jaisor/SNAP_Power_Mini/docs/images/pcb-iso.png

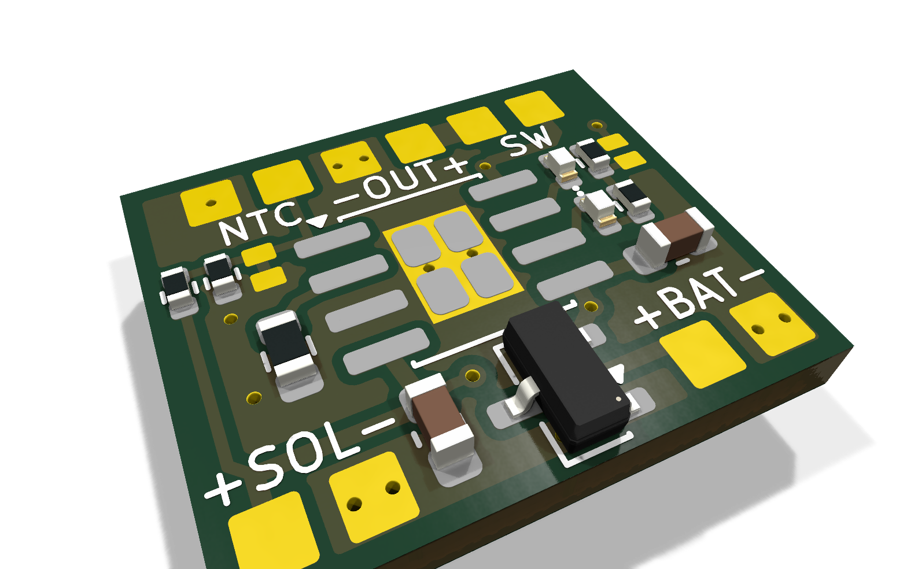
docs/images/pcb-iso.png
