jaisor/SNAP_Power_Mini/SNAP_Power_Mini.kicad_pcb

## KiCad design SNAP_Power_Mini.kicad_pcb (2026-11-14)

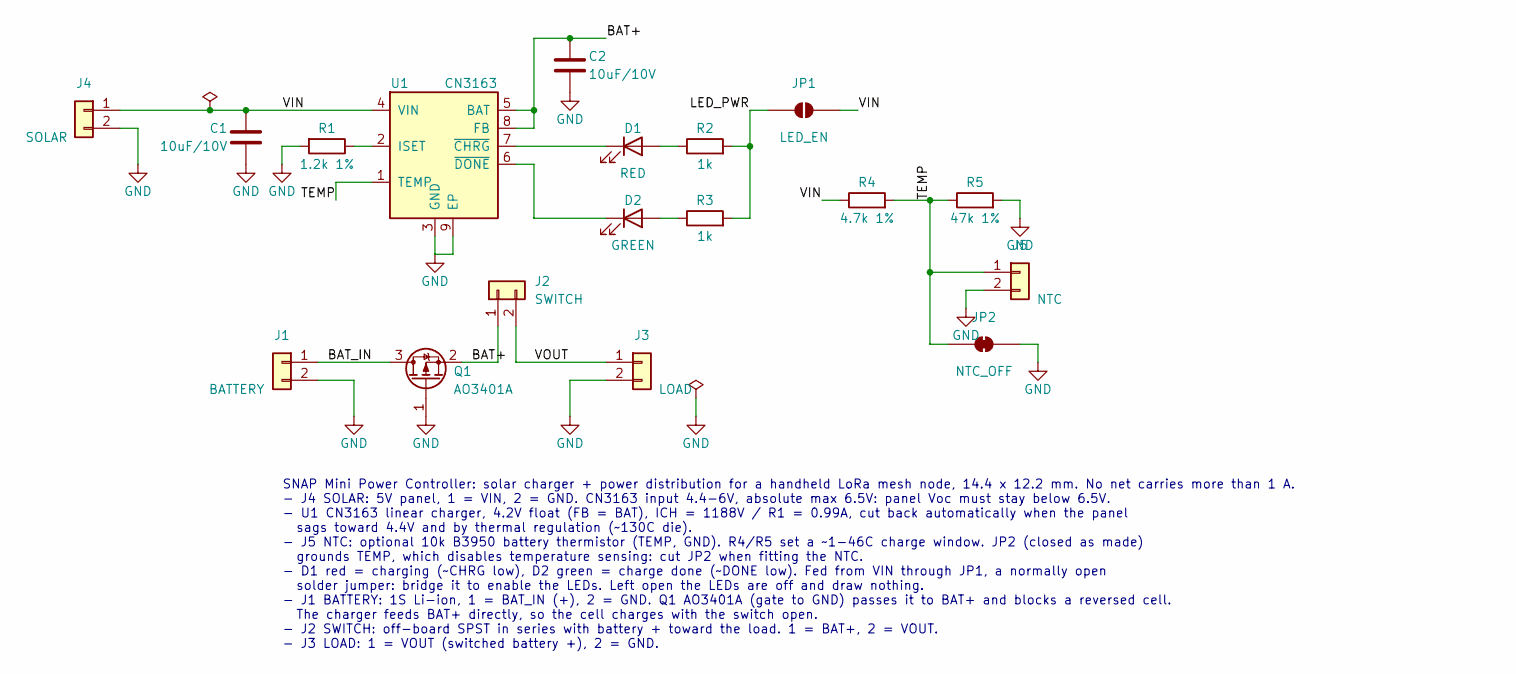
[picture p4: schematic SNAP_Power_Mini.kicad_sch, SNAP Mini Power Controller]

Parts:
C1, C2: 10uF/10V; C_0603_1608Metric
D1: RED; LED_0402_1005Metric
D2: GREEN; LED_0402_1005Metric
J1: BATTERY; WirePad_1x02_SMD_1.4x1.5mm_P2.0mm
J2: SWITCH; WirePad_1x02_SMD_1.4x1.5mm_P2.0mm
J3: LOAD; WirePad_1x02_SMD_1.4x1.5mm_P2.0mm
J4: SOLAR; WirePad_1x02_SMD_1.4x1.5mm_P2.0mm
J5: NTC; WirePad_1x02_SMD_1.4x1.5mm_P2.0mm
JP1: LED_EN; SolderJumper-2_P0.9mm_Open_Pad0.6x0.8mm
JP2: NTC_OFF; SolderJumper-2_P0.9mm_Bridged_Pad0.6x0.8mm
Q1: AO3401A; SOT-23
R1: 1.2k 1%; R_0603_1608Metric
R2, R3: 1k; R_0402_1005Metric
R4: 4.7k 1%; R_0402_1005Metric
R5: 47k 1%; R_0402_1005Metric
U1: CN3163; SOIC-8-1EP_3.9x4.9mm_P1.27mm_EP2.41x3.3mm

Connections:
/BAT+: C2.1, J2.1, Q1.2 (S), U1.5 (BAT), U1.8 (FB)
/BAT_IN: J1.1, Q1.3 (D)
/LED_PWR: JP1.1 (A), R2.2, R3.2
/TEMP: J5.1, JP2.1 (A), R4.2, R5.1, U1.1 (TEMP)
/VIN: C1.1, J4.1, JP1.2 (B), R4.1, U1.4 (VIN)
/VOUT: J2.2, J3.1
GND: C1.2, C2.2, J1.2, J3.2, J4.2, J5.2, JP2.2 (B), Q1.1 (G), R1.2, R5.2, U1.3 (GND), U1.9 (EP)
unnamed: D1.2 (A), R2.1
unnamed: D1.1 (K), U1.7 (~CHRG)
unnamed: D2.2 (A), R3.1
unnamed: D2.1 (K), U1.6 (~DONE)
unnamed: R1.1, U1.2 (ISET)

Notes on the sheet:
SNAP Mini Power Controller: solar charger + power distribution for a handheld LoRa mesh node, 14.4 x 12.2 mm. No net carries more than 1 A. - J4 SOLAR: 5V panel, 1 = VIN, 2 = GND. CN3163 input 4.4-6V, absolute max 6.5V: panel Voc must stay below 6.5V. - U1 CN3163 linear charger, 4.2V float (FB = BA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

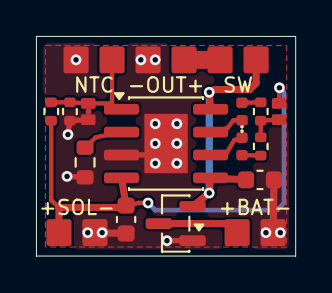
[picture p5: board SNAP_Power_Mini.kicad_pcb from above]

Board: 2 copper layers, 14.4 x 12.2 mm, 18 parts (0 on the bottom side), 12 nets.
