jaisor/SNAP_Power_Mini/(commit log)

2026-10-30 feat: add 20x10 mm wire-pad power distribution board
    Minimal PDB with solder pads for a battery, an off-board switch in series
    with battery +, and a load, plus two M2 mounting holes. The switch is wired
    off-board because slide switches small enough for this footprint are
    rated around 0.5 A.
    Pads are 2.9 x 3.6 mm in three columns (BAT, SW, OUT), + row on top. F.Cu
    carries the BAT+ bridge; on B.Cu a VOUT zone and a GND zone cross under the
    switch pads, reached by via-in-pad. Rated about 5 A on 1 oz copper,
    limited by the three VOUT vias and the 2.3 mm GND strip.
    Corners are square so panels can be V-scored edge to edge; rounded corners
    would need tab routing with gaps between boards.
    The sc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
    [MiniPDB.kicad_pcb, MiniPDB.kicad_sch]
2026-10-30 feat: add CN3163 solar charger with status LEDs and solar pads
    Add a CN3163 linear charger, modelled on the SD05CRMA module and the
    datasheet's Figure 1: R_ISET 1.2k for 0.99 A, FB tied to BAT for a
    4.2 V float, TEMP grounded (bare cell, no NTC), 10 uF on VIN and BAT.
    Red and green 0402 LEDs with 1k resistors hang from VIN on ~CHRG and
    ~DONE, so they light only while the panel supplies power.
    The charger feeds BAT+ on the cell side of the switch, so the cell
    charges with the switch open and the panel never powers the load
    while it is switched off.
    No net carries more than 1 A, so the wire pads shrink to 2.0 x 2.1 mm
    and the v1 copper planes become 0.4 mm tracks. A SOL pad pair joins
    the pa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
    [MiniPDB.kicad_pcb, MiniPDB.kicad_sch]
2026-10-30 refactor: rename project to SolarMeshMiniPDB
    The board is the power stage of a mini handheld solar LoRa mesh node,
    so the name now says that. Rename the KiCad project files, the project
    symbol and footprint libraries (and the lib IDs that point at them),
    title blocks, docs and the Gerber zip name.
    Schematic UUIDs stay seeded with the old name (UUID_SEED) so symbol
    identities and the footprint links do not churn.
    The back silkscreen now reads "SolarMeshMiniPDB" / "v2.0 by
    JaisorGadgets". The second line sits below the M2 holes, so it may use
    the board width instead of the gap between the holes; that keeps it at
    the 0.8 mm minimum text height instead of shrinking it to 0.76 mm.
    ERC: 0 items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
    [SolarMeshMiniPDB.kicad_pcb, SolarMeshMiniPDB.kicad_sch]
2026-10-31 feat(fab): generate JLCPCB BOM and CPL with LCSC part numbers
    Add tools/fab-package.js, adapted from SolarNodeChargeController. It turns
    KiCad's BOM and position CSVs into JLCPCB-format BOM/CPL files, writes
    FAB_NOTES.txt and zips the Gerbers, replacing the python zip one-liner.
    Every BOM line has an LCSC number, each checked on its jlcpcb.com part page:
    CN3163 C559031, 1.2k 0603 C22765, 1k 0402 C11702, 10uF 0603 C19702, and the
    NationStar 0402 LEDs C130719 (red) / C130723 (green). The CN3163 and LEDs are
    Extended parts.
    The CPL keeps KiCad's rotations with no per-package corrections, so the docs
    say to check U1 and the LED polarity in the assembler's preview. CPL
    coordinates match the Ger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
2026-11-12 refactor: rename project to SNAP Mini Power Controller
    Files, KiCad libraries and lib IDs become SNAP_Power_Mini, matching the
    GitHub repo (renamed from SolarMeshMiniPDB, which GitHub redirects). File
    names can't carry the spaces, so the full name "SNAP Mini Power Controller"
    goes in the schematic and board title blocks, README, CLAUDE.md and the fab
    notes. Fab outputs are now SNAP_Power_Mini_v2.0_*.
    The full name is 16.7 mm wide at 0.8 mm, too wide for the 12.6 mm between
    the M2 holes, so the back silk swaps lines: "JaisorGadgets v2.0" between
    the holes, the name on the full-width line below.
    The schematic UUIDs stay seeded with "MiniPDB", so the symbol-footprint
    links survive. Regenerate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
    [SNAP_Power_Mini.kicad_pcb, SNAP_Power_Mini.kicad_sch]
2026-11-12 feat: add four solar inputs and reverse-battery protection
    J4 becomes a row of four panel + pads and a double-size shared return,
    spread across the bottom edge. Each panel reaches VIN through its own
    1N5819WS (D3-D6), so a shaded or unplugged panel can't sink current from
    the others and a panel wired backwards is blocked.
    Q1, an AO3401A between the battery pad and BAT+ with its gate to GND,
    guards against a reversed cell. A correct cell turns it on through the body
    diode, after which it conducts both ways, so the charger still charges
    through it. It sits under the BAT/SW pads, directly above the CN3163.
    The status LEDs now hang off JP1, a normally open solder jumper, so they
    draw nothing u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
    [SNAP_Power_Mini.kicad_pcb, SNAP_Power_Mini.kicad_sch]
2026-11-12 feat!: return to a minimal single-panel board with NTC support
    The four-panel version (ddf21a0) was no longer a minimal PDB. Back to one
    solar pad pair: the four 1N5819WS diodes and the extra solar pads are gone.
    The AO3401A reverse-battery guard and the JP1-gated status LEDs stay.
    Add the CN3163's battery temperature sensing. R4 (4.7k, VIN to TEMP) and
    R5 (47k, TEMP to GND) with a 10k B3950 thermistor on the new NTC pads allow
    charging between about 1 and 46 C; the datasheet's formulas give 4.86k and
    46.1k for 0-45 C. With no thermistor TEMP would sit at 91 % of VIN and
    block charging, so JP2, a jumper closed by a copper link (a net tie),
    grounds TEMP until it is cut.
    Remove the mounting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
    [SNAP_Power_Mini.kicad_pcb, SNAP_Power_Mini.kicad_sch]
2026-11-12 docs: show the board dimensions in the readme and renders
    The size was only stated in running text, and the renders gave no sense
    of scale for a board this small.
    Add a Dimensions table to the README (outline, thickness, pad size,
    pitch and each pad's distance from the left edge) and draw the width
    and height on the top and bottom renders.
    kicad-cli's render has no dimension layer, so tools/render-images.py
    renders both sides, cuts the board out of its soft shadow and draws the
    dimension lines with Pillow on a transparent canvas, in a mid grey that
    reads on GitHub's light and dark pages. The sizes are read from the
    Edge.Cuts outline. Via holes come out transparent as a side effect of
    dropp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
2026-11-14 feat: print ratings, a polarity warning and a disclaimer on the back
    The back only carried the name and version, so nothing on the board
    itself told the person wiring it what the limits are. The solar input
    has no protection at all: a reversed or over-voltage panel destroys the
    CN3163.
    The back now reads SNAP Power Mini / CHECK POLARITY / SOL MAX 6V 1A /
    OUT MAX 1A / JaisorGadgets / AS IS NO WARRANTY / v2.0, at the 0.8 mm
    minimum, in the bands between the vias. BACK_TEXT entries take their
    own x so the two ratings rows can sit in columns either side of U1's
    thermal vias. The back uses the short name; the schematic, title blocks
    and README title are unchanged.
    Only "AS IS NO WARRANTY" fits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
    [SNAP_Power_Mini.kicad_pcb]
2026-11-14 docs: license the design like SNAP Power Controller
    The repo had no licence, so nobody could legally reuse the design, and
    the README carried a hand-written disclaimer that did not match the
    sibling board's.
    Use the same terms as jaisor/SNAP_Power_Controller (files copied from
    its 9c4d5f3): CERN-OHL-P-2.0 for the hardware design and documentation,
    MIT for the scripts in tools/, each of which gains an SPDX line.
    The README's Disclaimer section becomes a Safety section worded like the
    other board's, with this board's own limits table and the same
    no-warranty paragraph (liability limited to the price paid), plus a
    License section with the copyright notice.
    The back silkscreen is unchanged: o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
